bruthaearl/chrimbus/README.md

# chrimbus
## chrimbus tree ornamets for the family

More details on my [blog](http://www.oakst.io)
