bruthaearl/chrimbus/res/screen_code.png

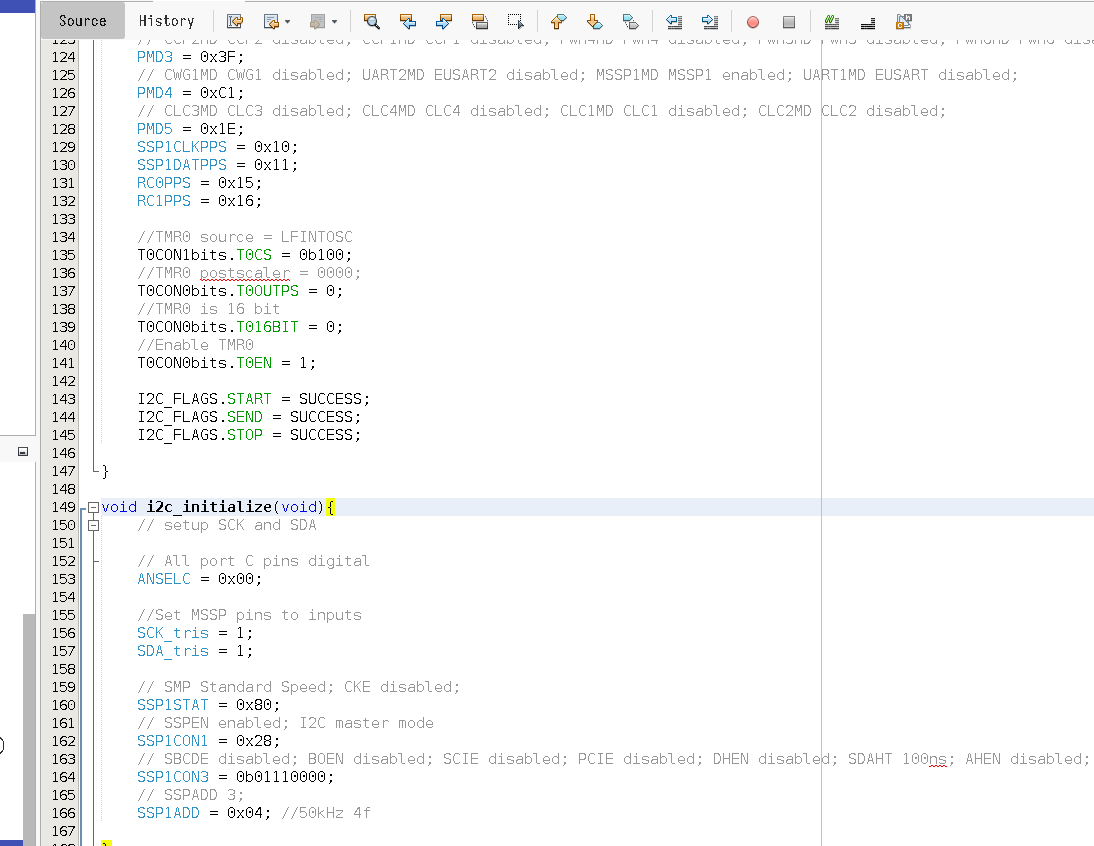
res/screen_code.png
