bruthaearl/chrimbus/res/screen_pcb.png

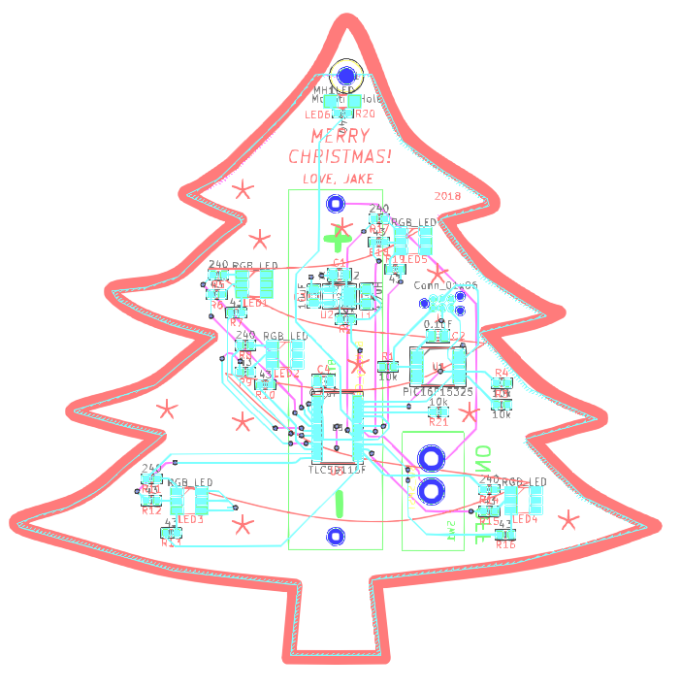
res/screen_pcb.png
