bruthaearl/chrimbus/res/screen_schematic.png

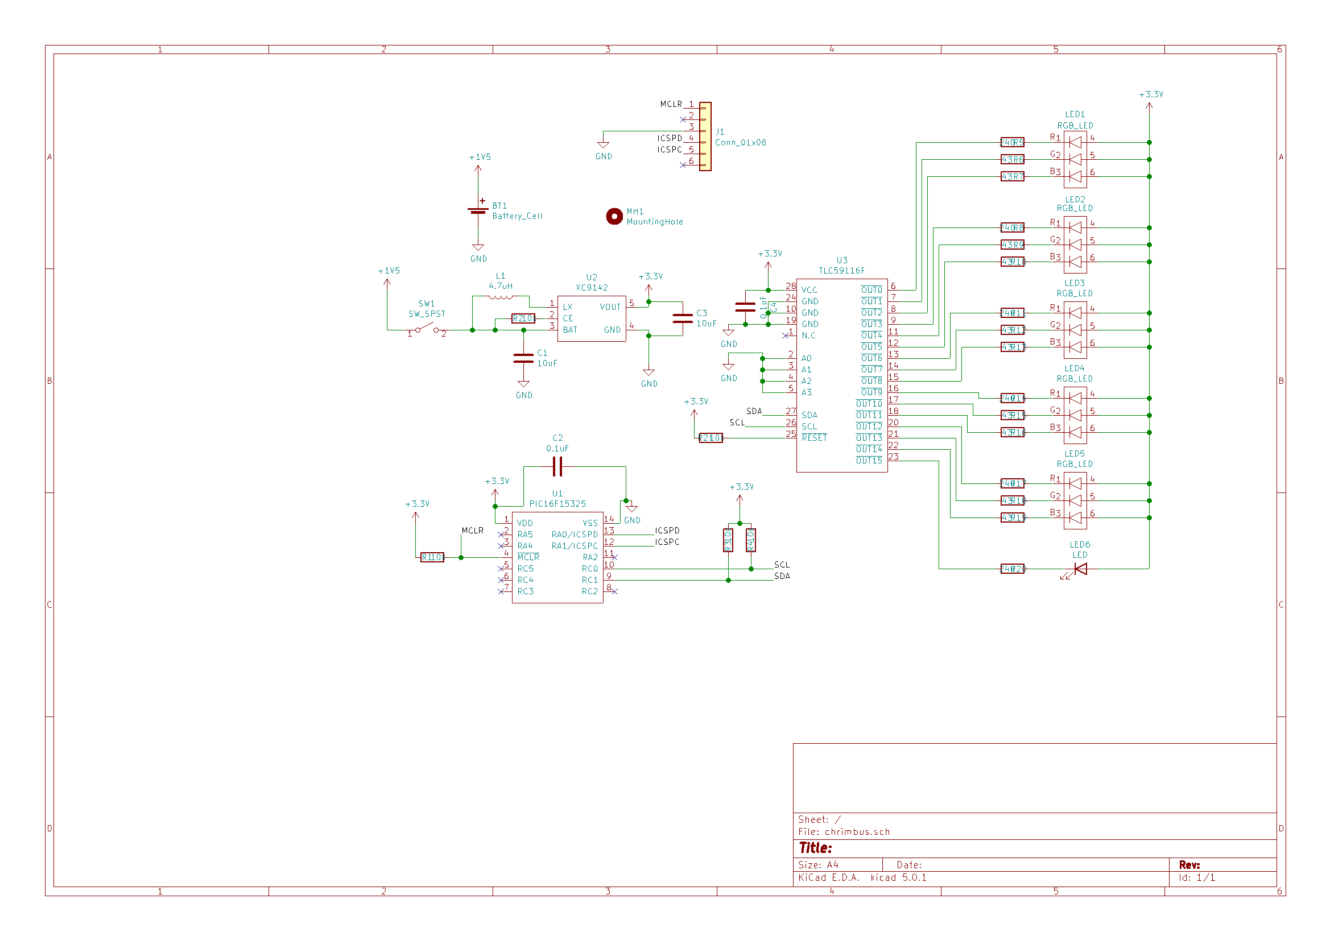
res/screen_schematic.png
