bruthaearl/chrimbus/res/art/art.dxf

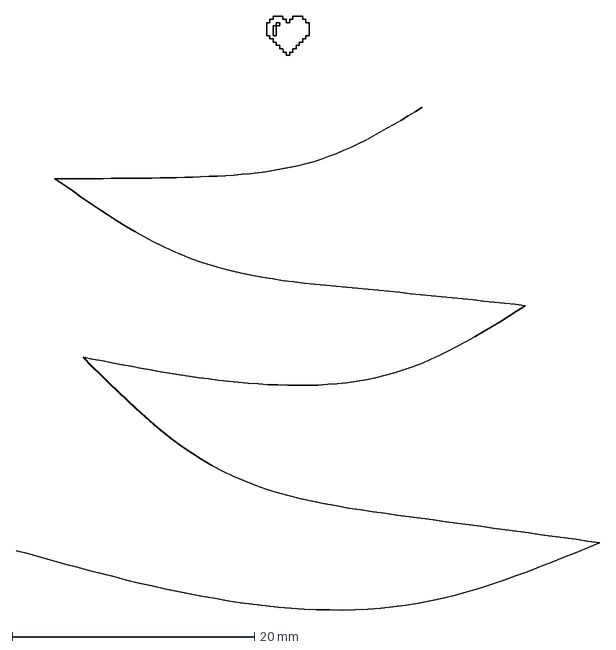
[picture p4: CAD file, 2018-11-26]
res/art/art.dxf
48.1 x 49.0 mm
