bruthaearl/chrimbus/res/art/tree_scaled.dxf

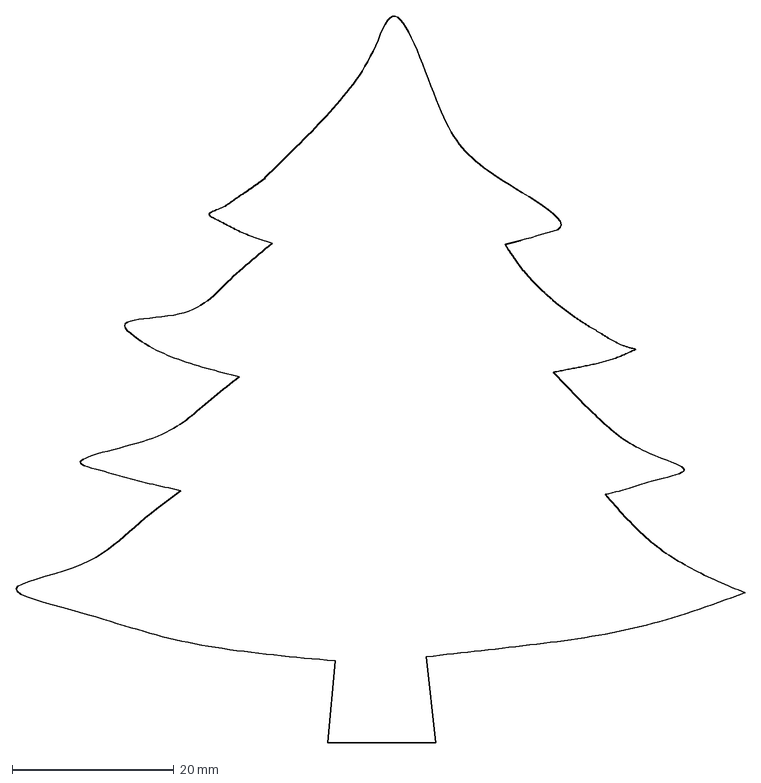
[picture p5: CAD file, 2018-11-21]
res/art/tree_scaled.dxf
90.0 x 89.7 mm
