bruthaearl/chrimbus/board/src/chrimbus/chrimbus.kicad_pcb

## KiCad design board/src/chrimbus/chrimbus.kicad_pcb (2018-12-16)

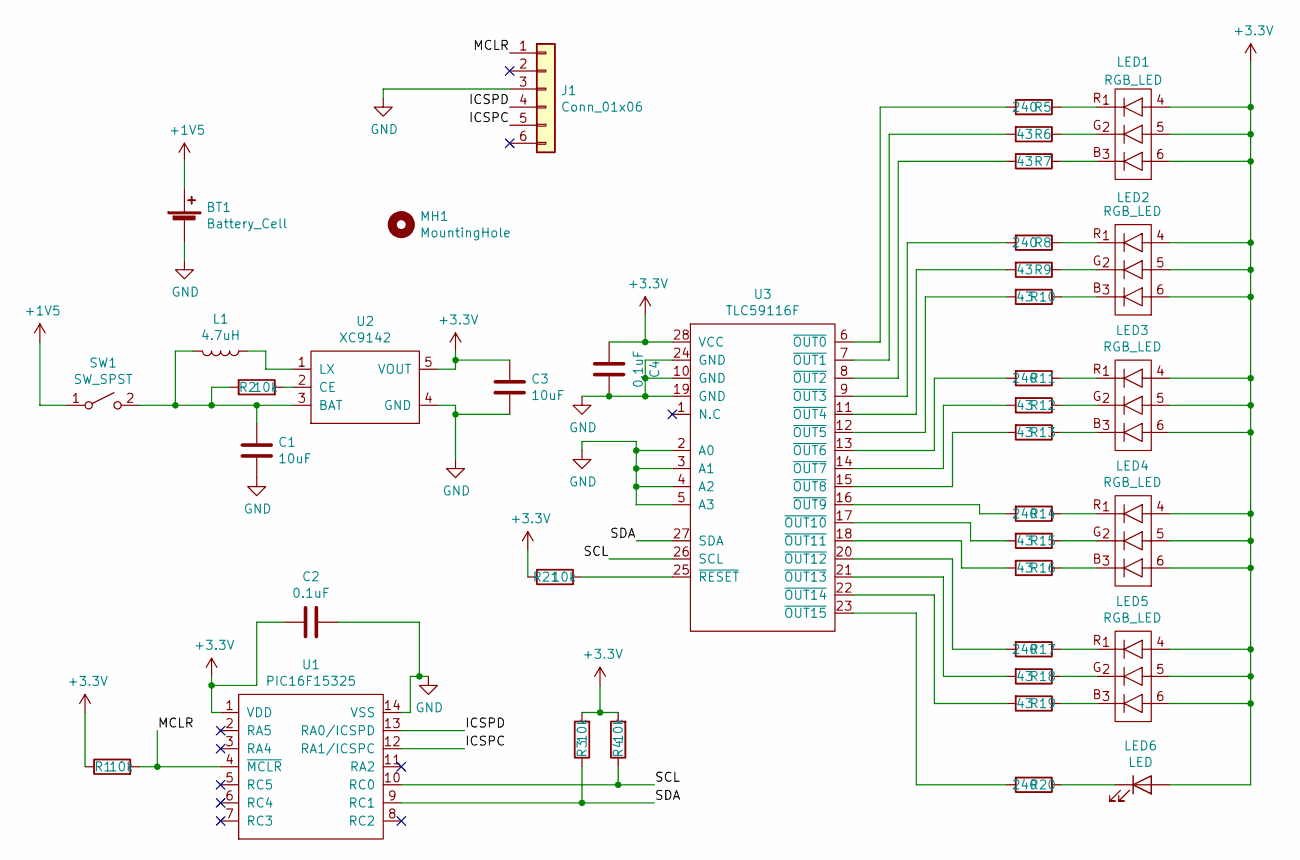
[picture p6: schematic chrimbus.sch]

Parts:
BT1: Battery_Cell; BCAAAPC
C1, C3: 10uF; C_0805_2012Metric
C2, C4: 0.1uF; C_0805_2012Metric
J1: Conn_01x06; Tag Connect
L1: 4.7uH; L_0805_2012Metric_Pad1.15x1.40mm_HandSolder
LED1, LED2, LED3, LED4, LED5: RGB_LED; APF3236LSEEZGKQBKC
LED6: LED; LTST-C150AKT
MH1: MountingHole; MountingHole_2.2mm_M2
R1, R2, R3, R4, R21: 10k; R_0603_1608Metric
R5, R8, R11, R14, R17, R20: 240; R_0603_1608Metric
R6, R7, R9, R10, R12, R13, R15, R16, R18, R19: 43; R_0603_1608Metric
SW1: SW_SPST; GF-123-0054
U1: PIC16F15325; TSSOP-14_4.4x5mm_P0.65mm
U2: XC9142; SOT-23-5_HandSoldering
U3: TLC59116F; TSSOP-28_4.4x9.7mm_P0.65mm

Connections:
+1V5: BT1.1 (+), SW1.1 (A)
+3V3: C2.2, C3.2, C4.2, LED1.4, LED1.5, LED1.6, LED2.4, LED2.5, LED2.6, LED3.4, LED3.5, LED3.6, LED4.4, LED4.5, LED4.6, LED5.4, LED5.5, LED5.6, LED6.2 (A), R1.1, R3.2, R4.2, R21.1, U1.1 (VDD), U2.5 (VOUT), U3.28 (VCC)
/ICSPC: J1.5, U1.12 (RA1/ICSPC)
/ICSPD: J1.4, U1.13 (RA0/ICSPD)
/MCLR: J1.1, R1.2, U1.4 (~MCLR)
/SCL: R4.1, U1.10 (RC0), U3.26 (SCL)
/SDA: R3.1, U1.9 (RC1), U3.27 (SDA)
GND: BT1.2 (-), C1.1, C2.1, C3.1, C4.1, J1.3, U1.14 (VSS), U2.4 (GND), U3.2 (A0), U3.3 (A1), U3.4 (A2), U3.5 (A3), U3.10 (GND), U3.19 (GND), U3.24 (GND)
unnamed: C1.2, L1.2, R2.1, SW1.2 (B), U2.3 (BAT)
unnamed: L1.1, U2.1 (LX)
unnamed: LED1.1, R5.1
unnamed: LED1.2, R6.1
unnamed: LED1.3, R7.1
unnamed: LED2.1, R8.1
unnamed: LED2.2, R9.1
unnamed: LED2.3, R10.1
unnamed: LED3.1, R11.1
unnamed: LED3.2, R12.1
unnamed: LED3.3, R13.1
unnamed: LED4.1, R14.1
unnamed: LED4.2, R15.1
unnamed: LED4.3, R16.1
unnamed: LED5.1, R17.1
unnamed: LED5.2, R18.1
unnamed: LED5.3, R19.1
unnamed: LED6.1 (K), R20.1
unnamed: R2.2, U2.2 (CE)
unnamed: R5.2, U3.6 (~OUT0)
unnamed: R6.2, U3.7 (~OUT1)
unnamed: R7.2, U3.8 (~OUT2)
unnamed: R8.2, U3.9 (~OUT3)
unnamed: R9.2, U3.11 (~OUT4)
unnamed: R10.2, U3.12 (~OUT5)
unnamed: R11.2, U3.13 (~OUT6)
unnamed: R12.2, U3.14 (~OUT7)
unnamed: R13.2, U3.15 (~OUT8)
unnamed: R14.2, U3.16 (~OUT9)
unnamed: R15.2, U3.17 (~OUT10)
unnamed: R16.2, U3.18 (~OUT11)
unnamed: R17.2, U3.20 (~OUT12)
unnamed: R18.2, U3.21 (~OUT13)
unnamed: R19.2, U3.22 (~OUT14)
unnamed: R20.2, U3.23 (~OUT15)
unnamed: R21.2, U3.25 (~RESET)

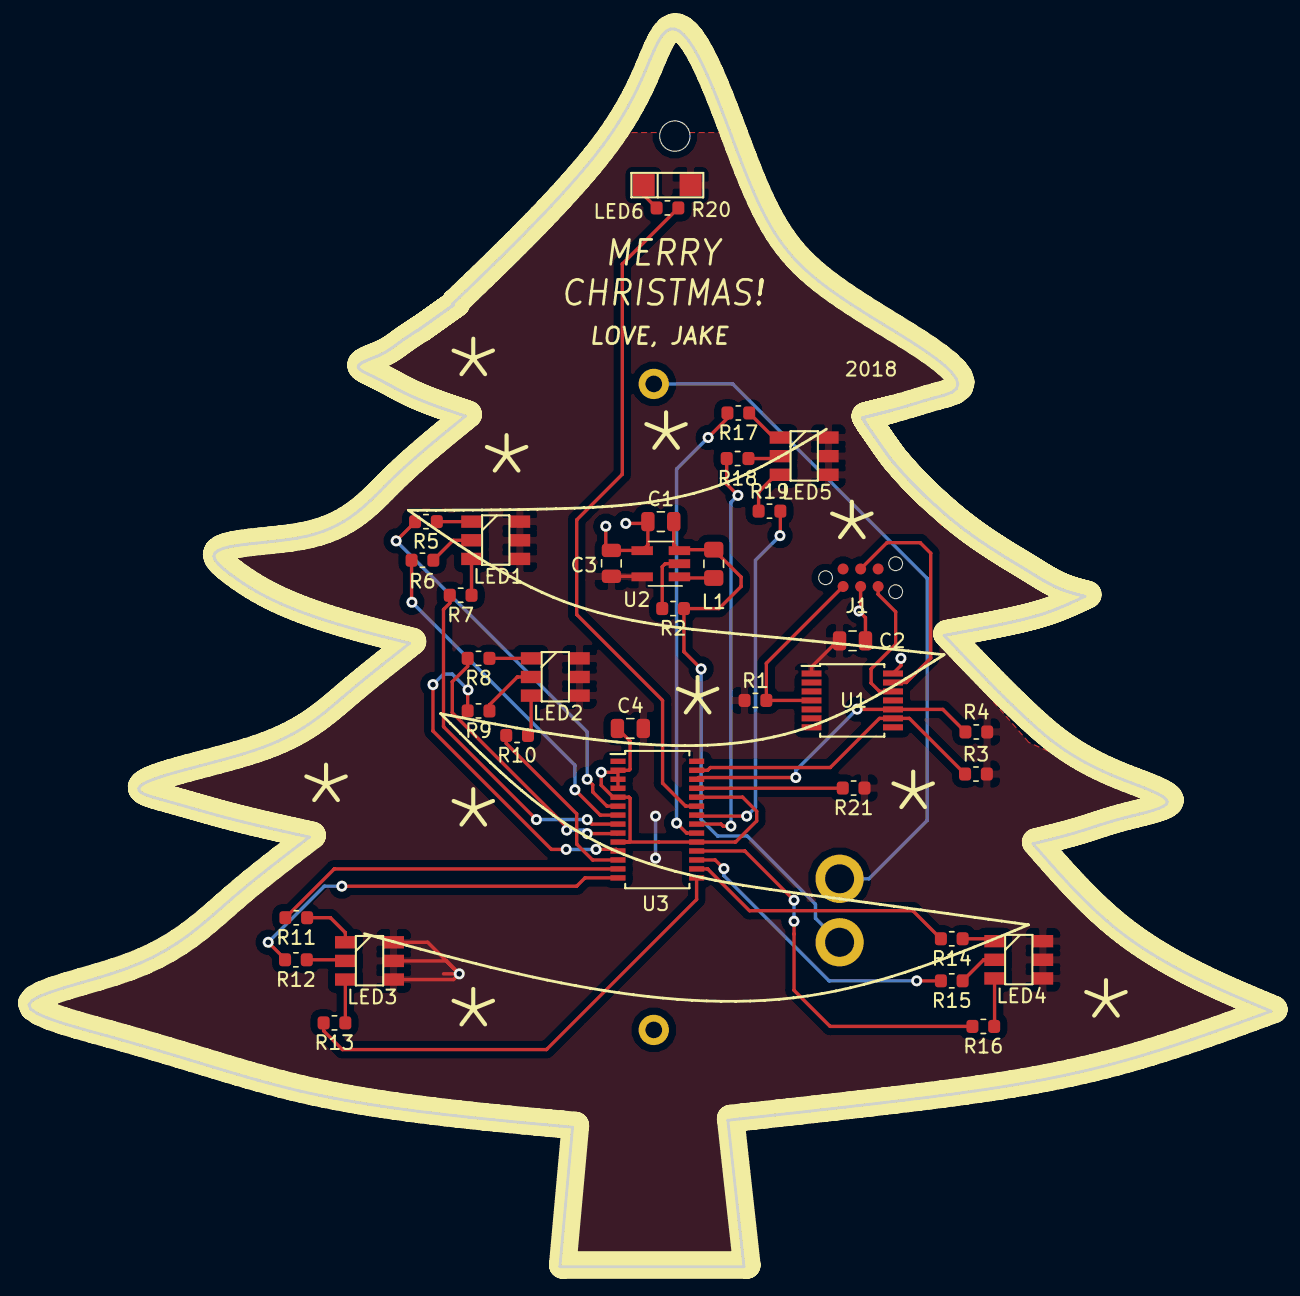
[picture p7: board chrimbus.kicad_pcb from above]

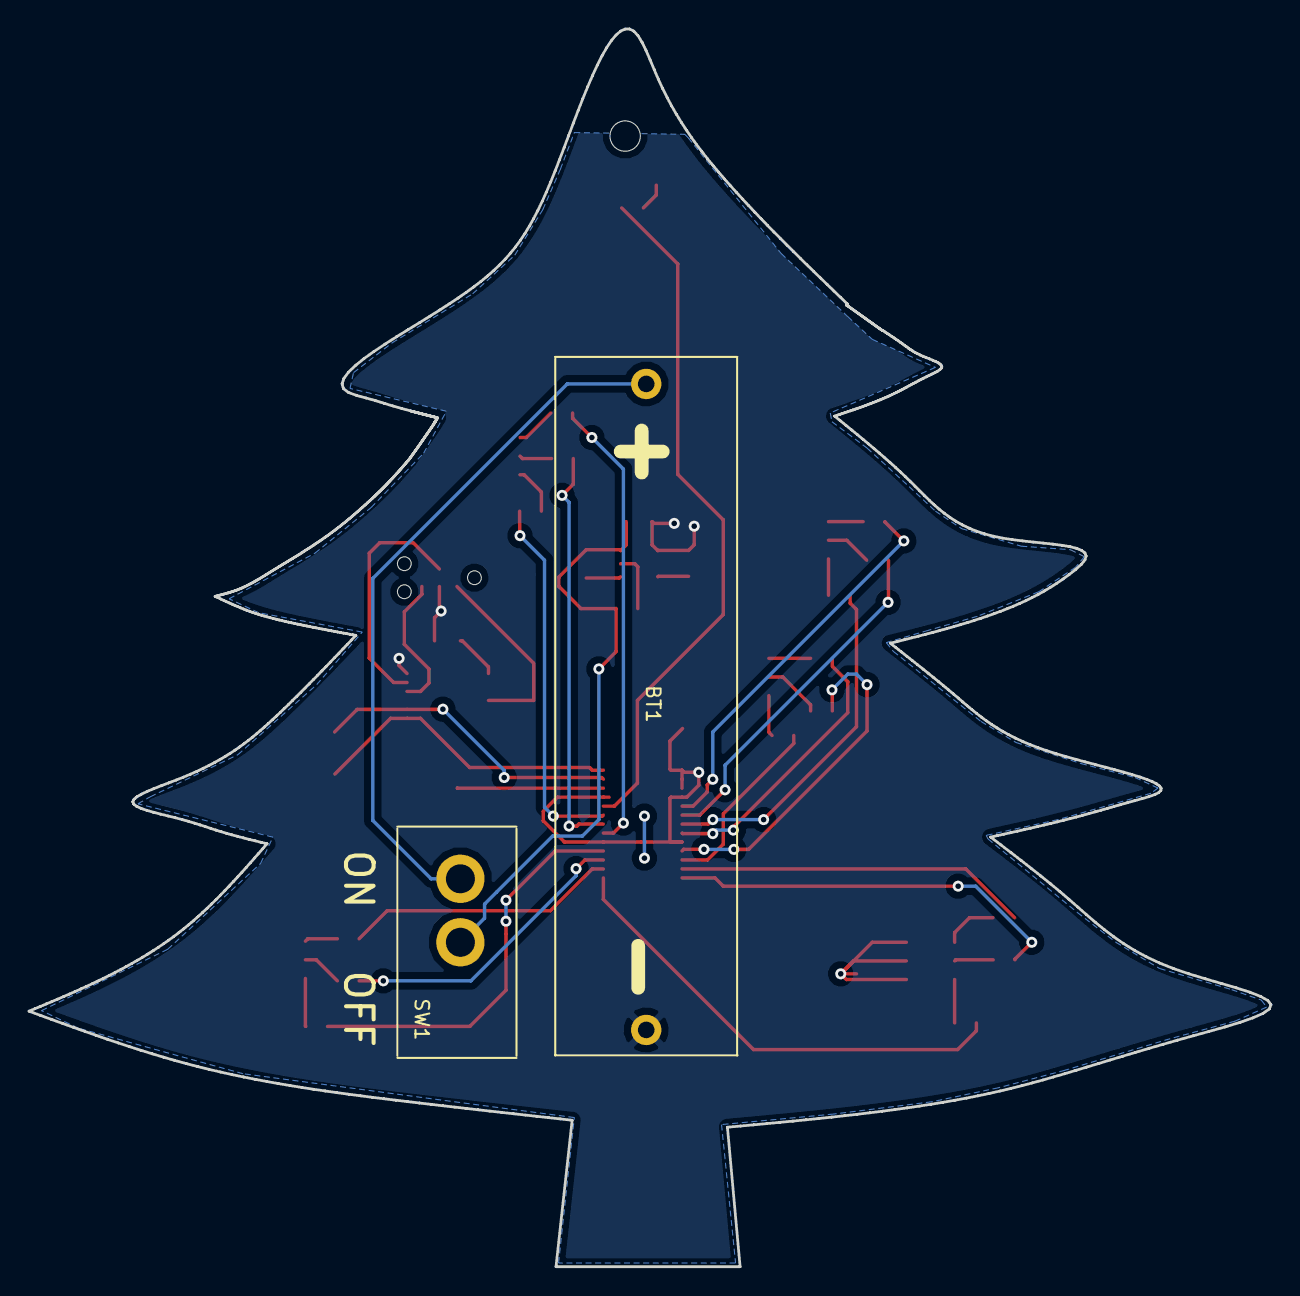
[picture p8: board chrimbus.kicad_pcb from below]

Board: 2 copper layers, 90.0 x 89.7 mm, 39 parts (2 on the bottom side), 44 nets.
