bruthaearl/chrimbus/(commit log)

2018-11-21 schematic done
    [chrimbus.kicad_pcb, chrimbus.sch, tree_scaled.dxf]
2018-11-26 last commit before dev branch
    [art.dxf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]
2018-11-30 led flash code cleanup
2018-12-16 dev final commit
    [chrimbus.kicad_pcb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]
2018-12-16 git cleanup
    [art.dxf, tree_scaled.dxf]
